c-lan/low-temf-scanner/hw/scanner.kicad_pcb

## KiCad design hw/scanner.kicad_pcb (2020-12-16)

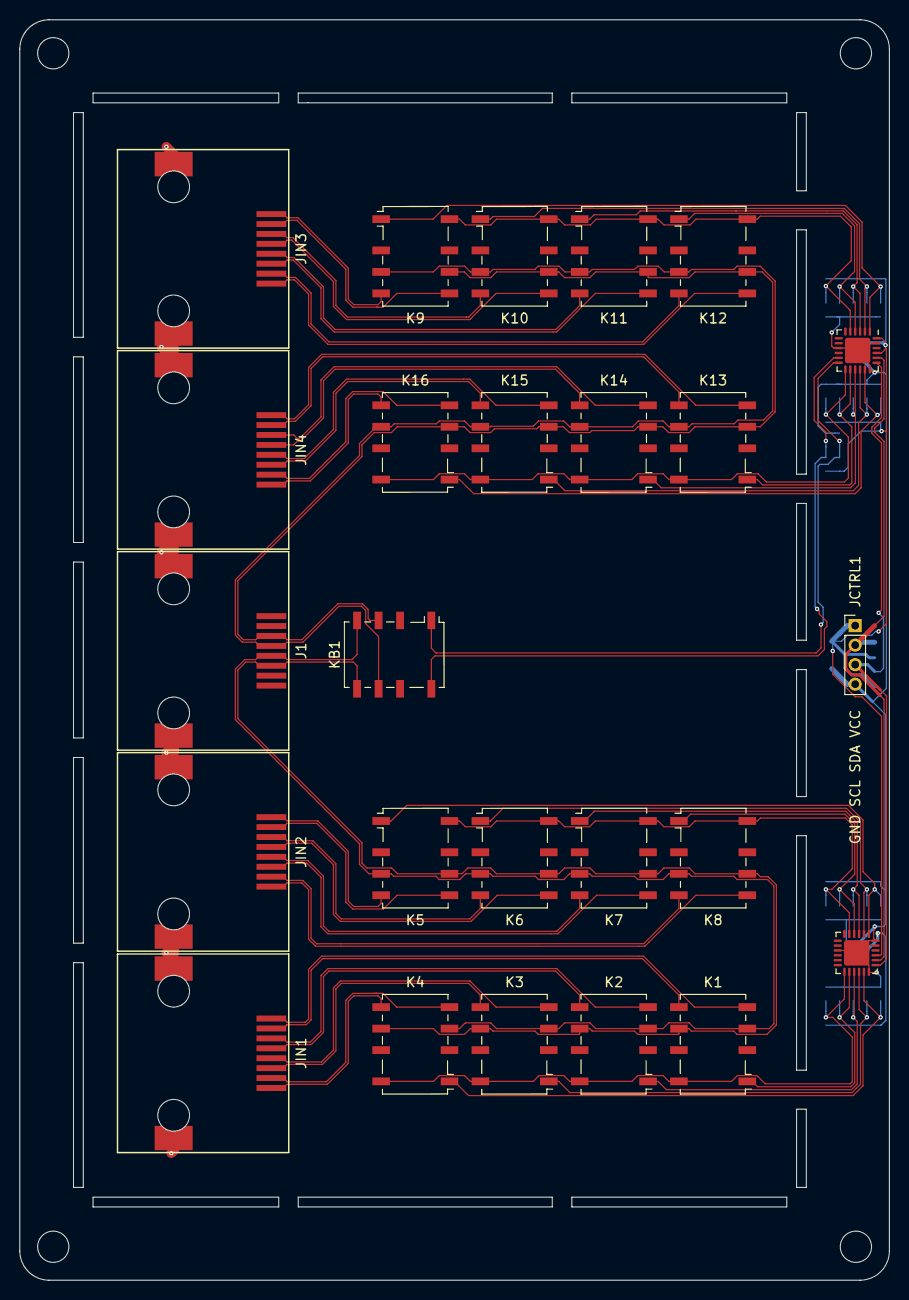
[picture p1: board scanner.kicad_pcb from above]

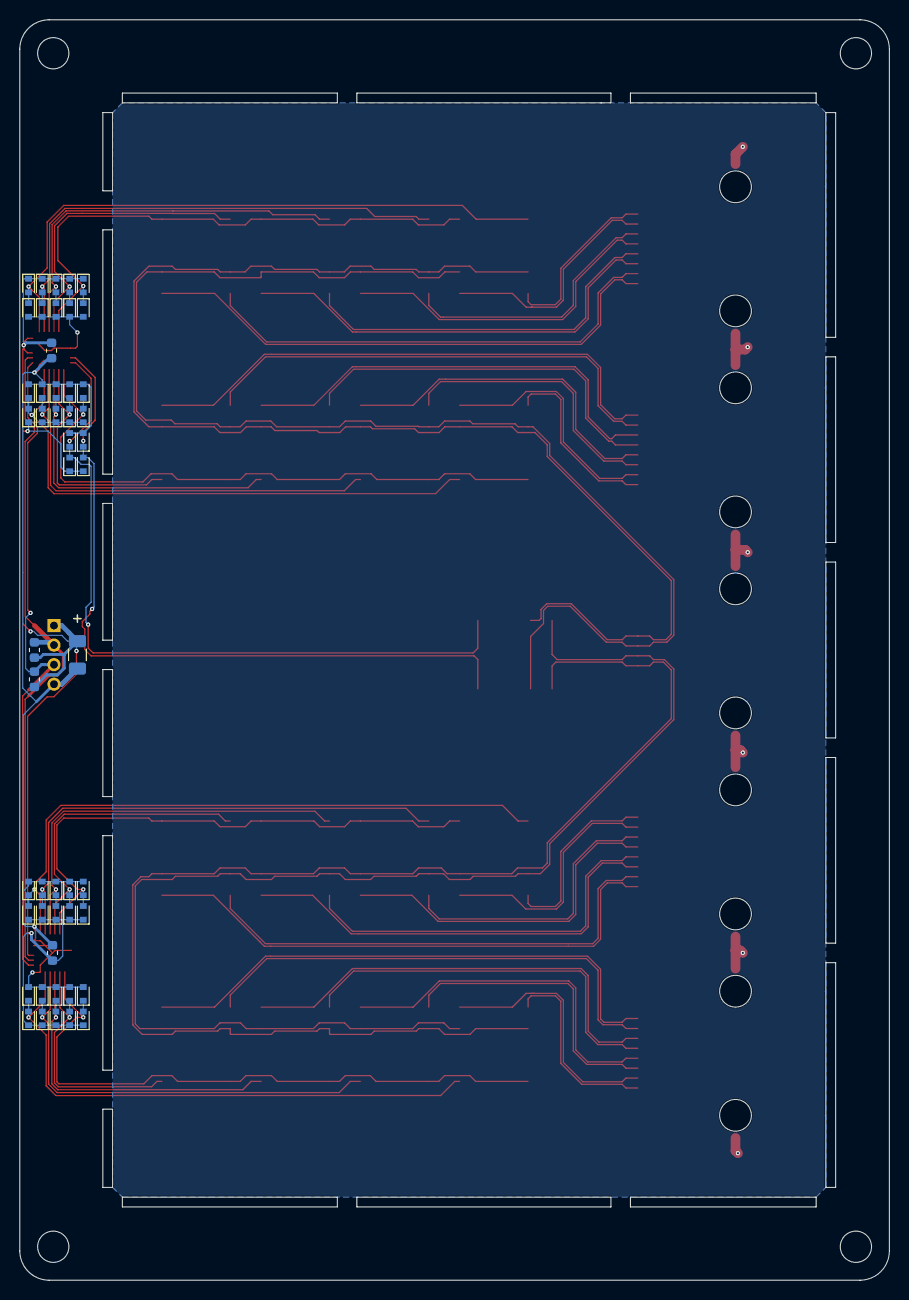
[picture p2: board scanner.kicad_pcb from below]

Board: 2 copper layers, 89.0 x 129.0 mm, 78 parts (49 on the bottom side), 63 nets.

Parts:
C1, C2: 100n; C_0603_1608Metric
C3: 15u; C_1206_3216Metric
D1, D2, D3, D4, D5, D6, D7, D8, D9, D10, D11, D12, D13, D14, D15, D16, D17, D18, D19, D20, D21, D22, D23, D24, D25, D26, D27, D28, D29, D30, D31, D32, D33, D34, D35, D36, D37, D38, D39, D40, D41, D42, D43, D44: D_Small; D_SOD-523
H1, H2, H3, H4: MountingHole; MountingHole_3.2mm_M3
J1: 6339160-1
JCTRL1: Conn_01x04; PinHeader_1x04_P2.00mm_Vertical
JIN1, JIN2, JIN3, JIN4: 6339160-1
K1, K2, K3, K4, K5, K6, K7, K8, K9, K10, K11, K12, K13, K14, K15, K16: G6KU-2; Relay_DPDT_Omron_G6K-2F-Y
KB1: G6KU-2; Relay_DPDT_Omron_G6K-2F-Y
R1, R2: 100k; R_0603_1608Metric
U1, U2: TCA9535RTWR; QFN-24-1EP_4x4mm_P0.5mm_EP2.6x2.6mm

Connections:
+3V3: C1.1, C2.1, C3.1, D1.1, D3.1, D5.1, D7.1, D9.1, D11.1, D13.1, D15.1, D17.1, D19.1, D21.1, D23.1, D25.1, D27.1, D29.1, D31.1, D33.1, D35.1, D37.1, D39.1, D41.1, D43.1, JCTRL1.1, R1.1, R2.1, U1.21, U1.24, U2.21
/CHA_COM1: D39.2, D40.1, K1.8, K2.8, K3.8, K4.8, U2.13
/CHA_COM2: D19.2, D20.1, K5.8, K6.8, K7.8, K8.8, U2.5
/CHA_N: J1.4, K1.3, K2.3, K3.3, K4.3, K5.3, K6.3, K7.3, K8.3, KB1.4
/CHA_P: J1.3, K1.6, K2.6, K3.6, K4.6, K5.6, K6.6, K7.6, K8.6, KB1.5
/CHB_COM1: D37.2, D38.1, K9.8, K10.8, K11.8, K12.8, U1.5
/CHB_COM2: D17.2, D18.1, K13.8, K14.8, K15.8, K16.8, U1.13
/CHB_N: J1.6, K9.3, K10.3, K11.3, K12.3, K13.3, K14.3, K15.3, K16.3, KB1.3
/CHB_P: J1.5, K9.6, K10.6, K11.6, K12.6, K13.6, K14.6, K15.6, K16.6, KB1.6
/SCL: JCTRL1.3, R2.2, U1.19, U2.19
/SDA: JCTRL1.2, R1.2, U1.20, U2.20
/SW0: D35.2, D36.1, K4.1, U2.17
/SW1: D31.2, D32.1, K3.1, U2.16
/SW2: D27.2, D28.1, K2.1, U2.15
/SW3: D23.2, D24.1, K1.1, U2.14
/SW4: D15.2, D16.1, K8.1, U2.4
/SW5: D11.2, D12.1, K7.1, U2.3
/SW6: D7.2, D8.1, K6.1, U2.2
/SW7: D3.2, D4.1, K5.1, U2.1
/SW8: D13.2, D14.1, K12.1, U1.4
/SW9: D9.2, D10.1, K11.1, U1.3
/SW10: D5.2, D6.1, K10.1, U1.2
/SW11: D1.2, D2.1, K9.1, U1.1
/SW12: D33.2, D34.1, K16.1, U1.17
/SW13: D29.2, D30.1, K15.1, U1.16
/SW14: D25.2, D26.1, K14.1, U1.15
/SW15: D21.2, D22.1, K13.1, U1.14
/SWCOMB: D43.2, D44.1, KB1.1, U1.12
/SWCOMB_COM: D41.2, D42.1, KB1.8, U1.11
/cha_0_3/CH0_N: JIN1.2, K4.4
/cha_0_3/CH0_P: JIN1.1, K4.5
/cha_0_3/CH1_N: JIN1.4, K3.4
/cha_0_3/CH1_P: JIN1.3, K3.5
/cha_0_3/CH2_N: JIN1.6, K2.4
/cha_0_3/CH2_P: JIN1.5, K2.5
/cha_0_3/CH3_N: JIN1.8, K1.4
/cha_0_3/CH3_P: JIN1.7, K1.5
/cha_4_7/CH0_N: JIN2.2, K8.4
/cha_4_7/CH0_P: JIN2.1, K8.5
/cha_4_7/CH1_N: JIN2.4, K7.4
/cha_4_7/CH1_P: JIN2.3, K7.5
/cha_4_7/CH2_N: JIN2.6, K6.4
/cha_4_7/CH2_P: JIN2.5, K6.5
/cha_4_7/CH3_N: JIN2.8, K5.4
/cha_4_7/CH3_P: JIN2.7, K5.5
/chb_0_3/CH0_N: JIN3.2, K12.4
/chb_0_3/CH0_P: JIN3.1, K12.5
/chb_0_3/CH1_N: JIN3.4, K11.4
/chb_0_3/CH1_P: JIN3.3, K11.5
/chb_0_3/CH2_N: JIN3.6, K10.4
/chb_0_3/CH2_P: JIN3.5, K10.5
/chb_0_3/CH3_N: JIN3.8, K9.4
/chb_0_3/CH3_P: JIN3.7, K9.5
/chb_4_7/CH0_N: JIN4.2, K16.4
/chb_4_7/CH0_P: JIN4.1, K16.5
/chb_4_7/CH1_N: JIN4.4, K15.4
/chb_4_7/CH1_P: JIN4.3, K15.5
/chb_4_7/CH2_N: JIN4.6, K14.4
/chb_4_7/CH2_P: JIN4.5, K14.5
/chb_4_7/CH3_N: JIN4.8, K13.4
/chb_4_7/CH3_P: JIN4.7, K13.5
GNDA: J1.SH, JIN1.SH, JIN2.SH, JIN3.SH, JIN4.SH
GNDD: C1.2, C2.2, C3.2, D2.2, D4.2, D6.2, D8.2, D10.2, D12.2, D14.2, D16.2, D18.2, D20.2, D22.2, D24.2, D26.2, D28.2, D30.2, D32.2, D34.2, D36.2, D38.2, D40.2, D42.2, D44.2, JCTRL1.4, U1.9, U1.18, U1.23, U1.25, U2.9, U2.18, U2.23, U2.24, U2.25
