c-lan/low-temf-scanner/sw/src/main.c

#include <stdlib.h>
#include <stdio.h>
#include <string.h>
#include <libopencm3/stm32/rcc.h>
#include <libopencm3/stm32/gpio.h>
#include <libopencm3/cm3/scb.h>
#include <libopencm3/cm3/systick.h>

#include "commands.h"
#include "switching.h"
#include "timing.h"
#include "serial.h"

int main(void)
{
    rcc_clock_setup_in_hse_8mhz_out_72mhz();

    rcc_periph_clock_enable(RCC_AFIO);
    rcc_periph_clock_enable(RCC_GPIOA);
    rcc_periph_clock_enable(RCC_GPIOB);
    rcc_periph_clock_enable(RCC_GPIOC);

    gpio_primary_remap(AFIO_MAPR_SWJ_CFG_JTAG_OFF_SW_ON, AFIO_MAPR_I2C1_REMAP);

    gpio_set_mode(GPIOC, GPIO_MODE_OUTPUT_2_MHZ, GPIO_CNF_OUTPUT_PUSHPULL, GPIO13);
    gpio_set(GPIOC, GPIO13);

    for (int i = 0; i < 0x800000; i++)
        __asm__("nop");

    timingInit();
    serialInit(cmdResetHandler, cmdReadHandler);
    cmdInit(serialWrite);
    switchingInit();

    while (1)
    {
        serialPoll();
    }
}
